aka0xxx6/meshdimmer/README.md

# meshdimmer
Controlling light using sensors in a mesh network.
