aka0xxx6/meshdimmer/docs/presentation/sensorFlow.pdf

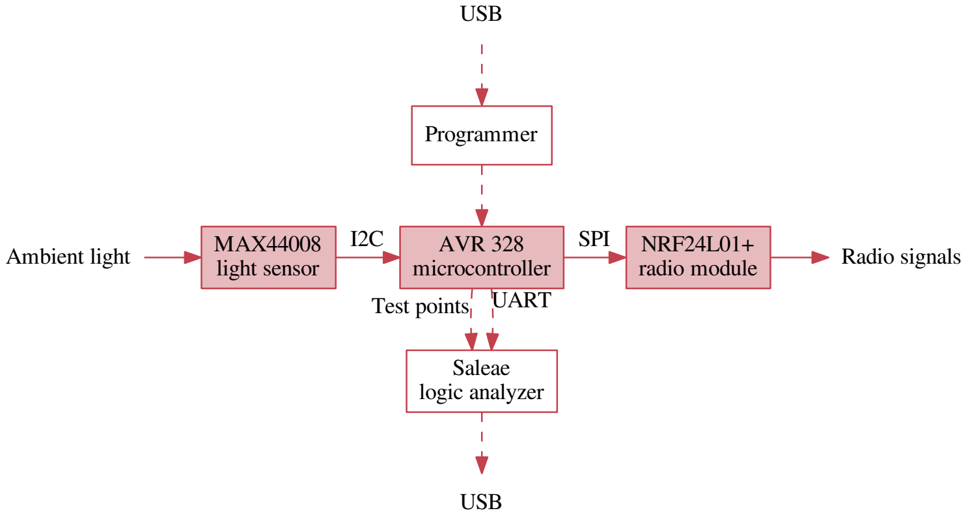
[picture p10: figure]
Ambient light; MAX44008; light sensor; AVR 328 microcontroller; NRF24L01+; radio module; SPI; Saleae logic analyzer; Test points UART; Radio signals; USB; Programmer
