aka0xxx6/meshdimmer/(threads)

Thread 1 (2015-02-15):

Change external interrupt pin for radio library

LarsH, 2015-02-15:
Make radio library use external interrupt 1 instead of 0, zero-crossing detection should have higher priority.

aka0xxx6, 2015-02-15:
Radio library changed and tested to use INT1.

Closed 2015-02-15.
