aka0xxx6/meshdimmer/hw/breakout.sch

## KiCad design hw/breakout.sch (2015-03-30)

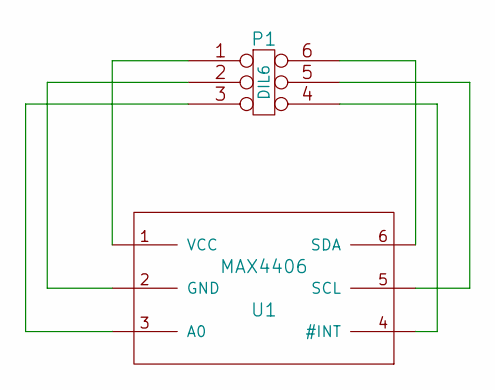
[picture p11: schematic breakout.sch]

Parts:
P1: DIL6
U1: MAX4406

Connections:
unnamed: P1.1, U1.1 (VCC)
unnamed: P1.2, U1.2 (GND)
unnamed: P1.3, U1.3 (A0)
unnamed: P1.4, U1.4 (#INT)
unnamed: P1.5, U1.5 (SCL)
unnamed: P1.6, U1.6 (SDA)
