aka0xxx6/meshdimmer/(commit log)

2015-02-02 - change from enable/disable global interrupt to enable/disable only specific interrupt - supress debug output
2015-02-15 read ADC value and send it via radio
2015-02-15 use DLL_wait_on_rx to check if interrupts are working
2015-02-16 Initial commit for dimmer with wireless communication
2015-02-16 Changed some dimmer pins, and added ADC measuring for test
2015-02-16 add wireless code for receiving adc values
2015-02-18 - variable used in interrupt should be volatile - replaced _delay_us by more precise inline NOPs
    [main.c]
2015-02-25 master SPI mode needs SS set high
2015-03-23 enable testing mode on wireless dimmer
2015-03-30 Added PCB for light sensor breakout board
    [breakout-append.kicad_pcb, breakout.kicad_pcb, breakout.sch]
2015-03-31 Added some lint-fixes and debug macros
    [debug.c, debug.h]
2015-03-31 Initial light sensor communication test code: talks with hardware
2015-04-05 Adjusted light sensor code to compile on a linux system
2015-04-13 Added power electronics section to report
2015-04-27 Made I2C work, and compile with radio
2015-05-05 send adc value also to light sensor
2015-05-05 Autodim using simple increase/decrease regulator now works!
2015-05-06 implemented PID controller for light sensor regulator
2015-06-07 Added some short information on power electronics
2015-06-10 Added lookup table for dimmer and adjusted linear regulator
2015-06-10 Added breakout pcb files
2015-06-10 Presentation: Added content and images related to light sensor
